anh-duynguyen/UCT_Micromouse_EEE3088F/Documentation/README.md

# Documentation

This folder contains datasheets and project documentation related to the EEE3088F course at UCT (in 2024).

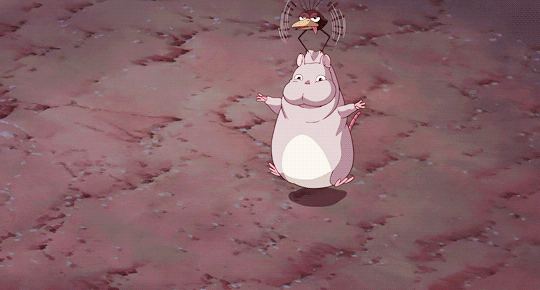
[picture p2: Documentation/Other/Formatting/tumblr_pffb1xFtaW1w67ki0o4_540.gif]
Mouse


## Sensing Module

This section contains datasheets and informational documents related to the sensors used and considered, as well as information about the STM32.

## Power Module

Find datasheets and informational documents related to power, usage and considerations, along with information about the STM32 in this section.

## Other

This section includes interfacing diagrams, the EEE3088F project brief, and a report regarding the Micromouse.

## Reports

Reports submitted for EEE3088F are available in both PDF and LaTeX formats. Please note that some of the links in these reports may not work due to the restructuring of this repository.
