anh-duynguyen/UCT_Micromouse_EEE3088F/Documentation/Reports/README.md

# Reports

This folder contains reports and latex files related to the EEE3088F course at UCT (in 2024).

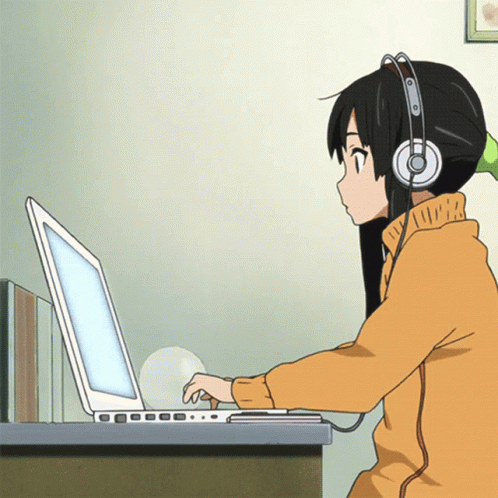
[picture p3: Documentation/Other/Formatting/tumblr_4429ca63f8072c9b22c431f62f48edd5_1a541d7b_500.gif]
Footprints
