anh-duynguyen/UCT_Micromouse_EEE3088F/Documentation/Power Module/README.md

# Power Module

Find datasheets and informational documents related to power, usage and considerations, along with information about the STM32 in this section.

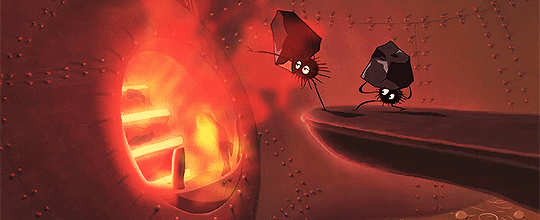
[picture p4: Documentation/Other/Formatting/tumblr_nyav9j0GF31tknp1oo2_540.gif]
Footprints
