anh-duynguyen/UCT_Micromouse_EEE3088F/Documentation/Sensing Module/README.md

# Sensing Module

This section contains datasheets and informational documents related to the sensors used and considered, as well as information about the STM32.

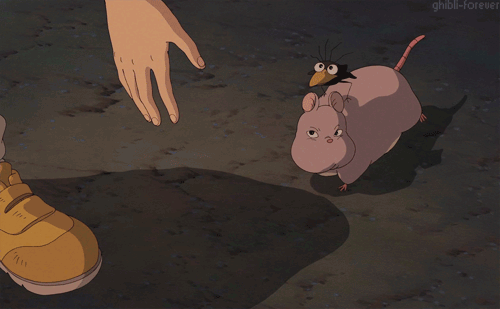
[picture p5: Documentation/Other/Formatting/tumblr_muf2ivJQ5h1rll7syo1_500.gif]
Footprints
