anh-duynguyen/UCT_Micromouse_EEE3088F/Documentation/Power Module/Datasheets/README.md

# Datasheets
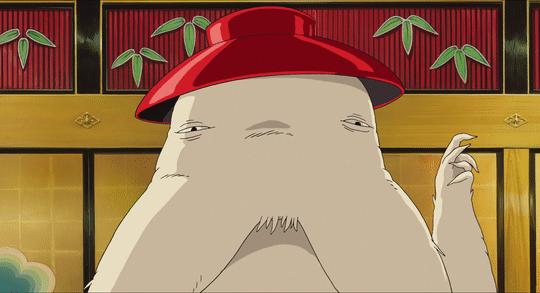
[picture p6: Documentation/Other/Formatting/0f9a2937e70205ddf1e4.gif]
Footprints
