anh-duynguyen/UCT_Micromouse_EEE3088F/Documentation/Sensing Module/Datasheets/README.md

# Datasheets
Footprints
