anh-duynguyen/UCT_Micromouse_EEE3088F/Documentation/Power Module/Footprints/README.md

# Footprints
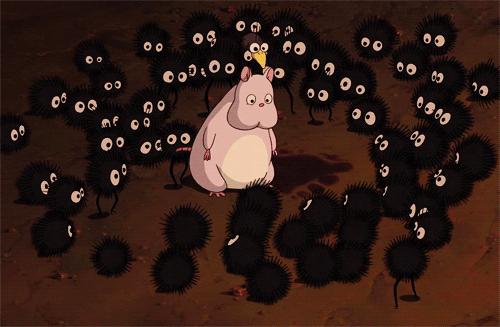
[picture p7: Documentation/Other/Formatting/45f478039f9f38e638831d6355e46289.gif]
Footprints
