anh-duynguyen/UCT_Micromouse_EEE3088F/Documentation/Sensing Module/KiCAD/Sensor_Schematic.pdf

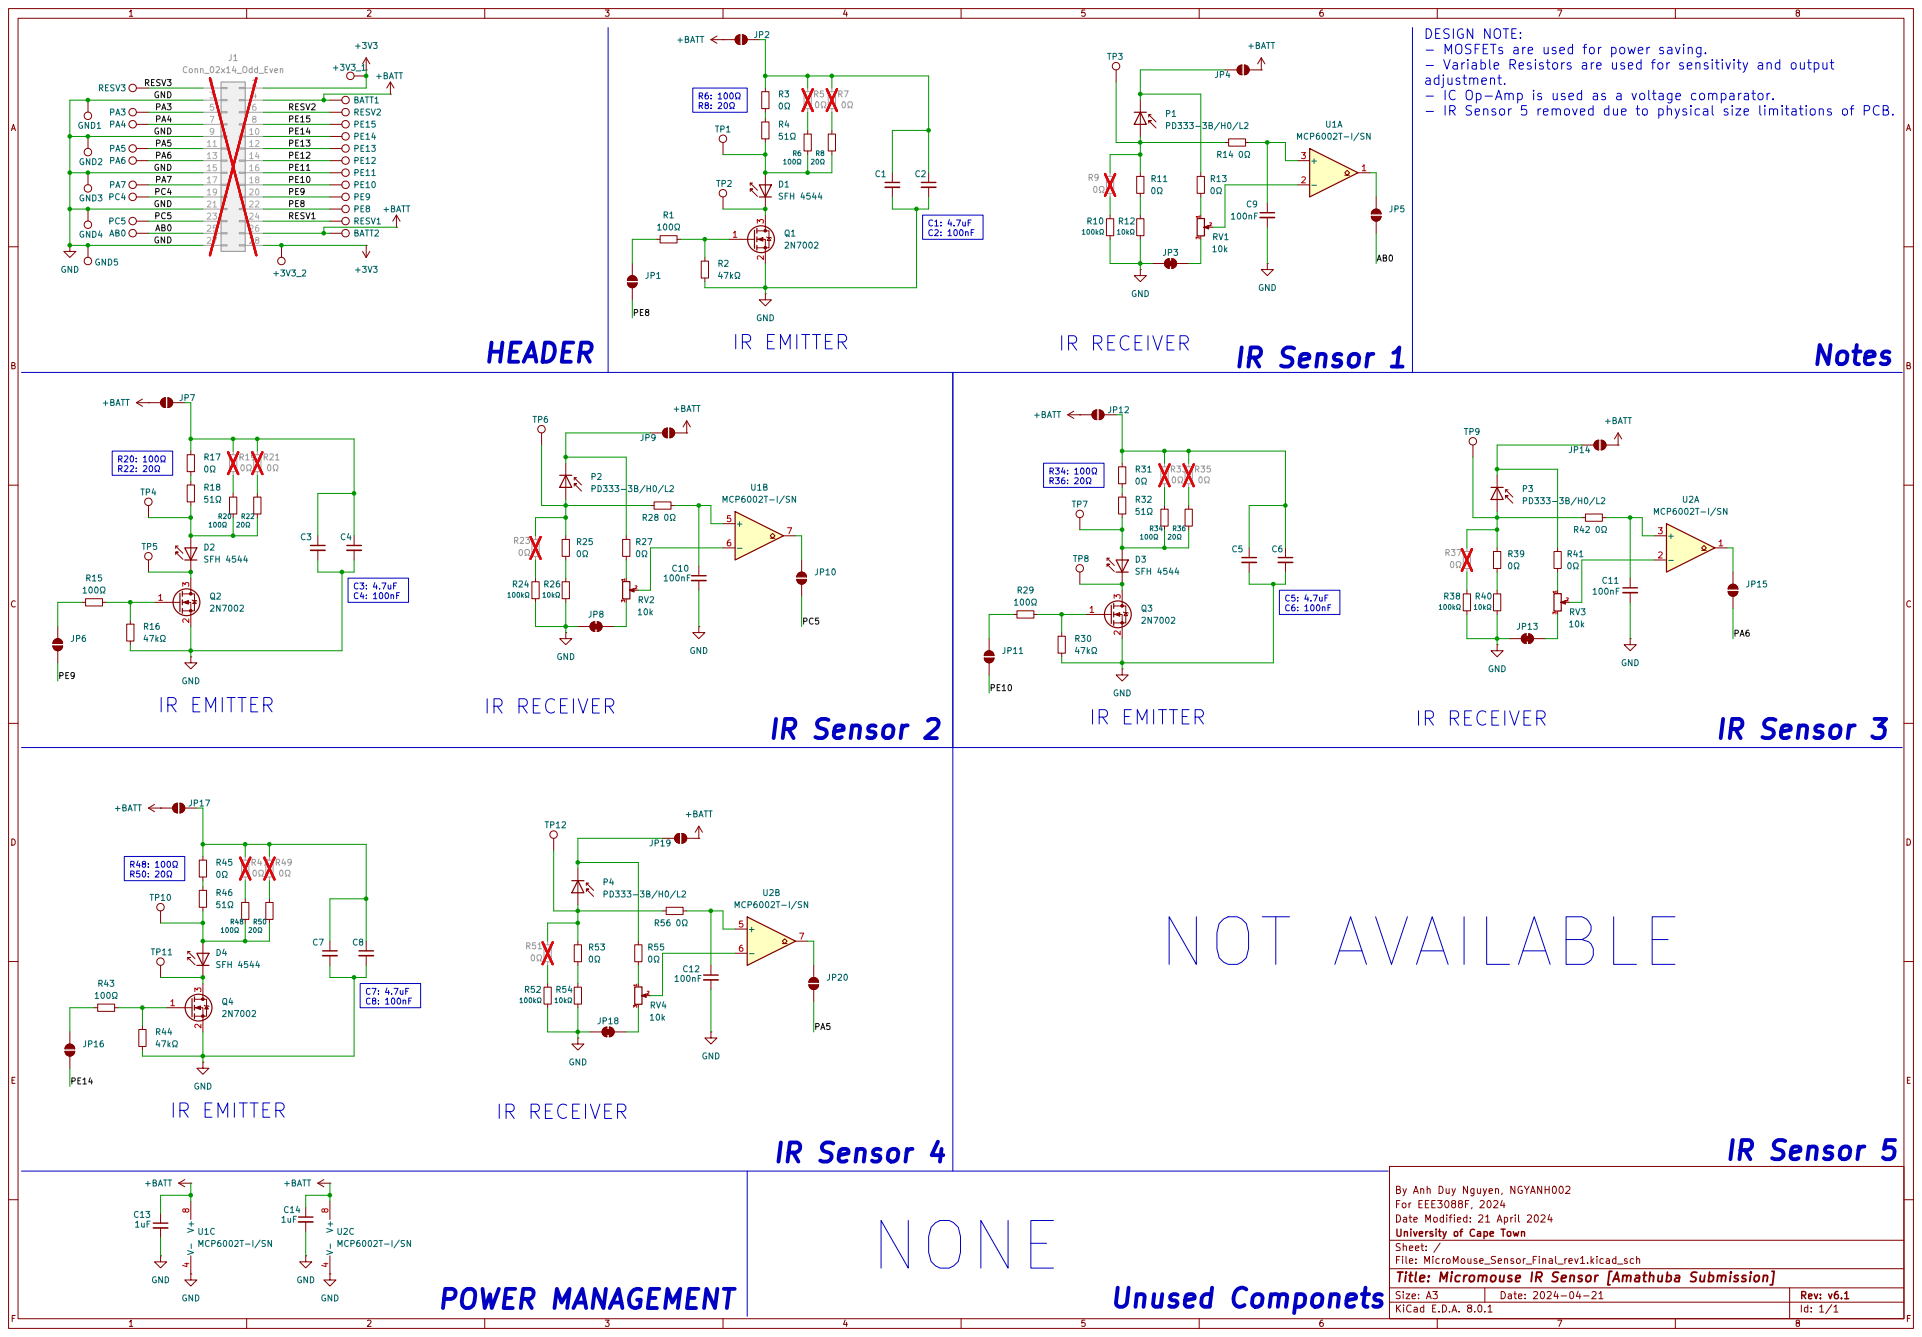
[picture p18: page 1]
