anh-duynguyen/UCT_Micromouse_EEE3088F/Documentation/Sensing Module/KiCAD/MicroMouse_Sensor_Amathuba/MicroMouse_Sensor_Amathuba.kicad_pcb

## KiCad design Documentation/Sensing Module/KiCAD/MicroMouse_Sensor_Amathuba/MicroMouse_Sensor_Amathuba.kicad_pcb (2024-04-21, last stored version)

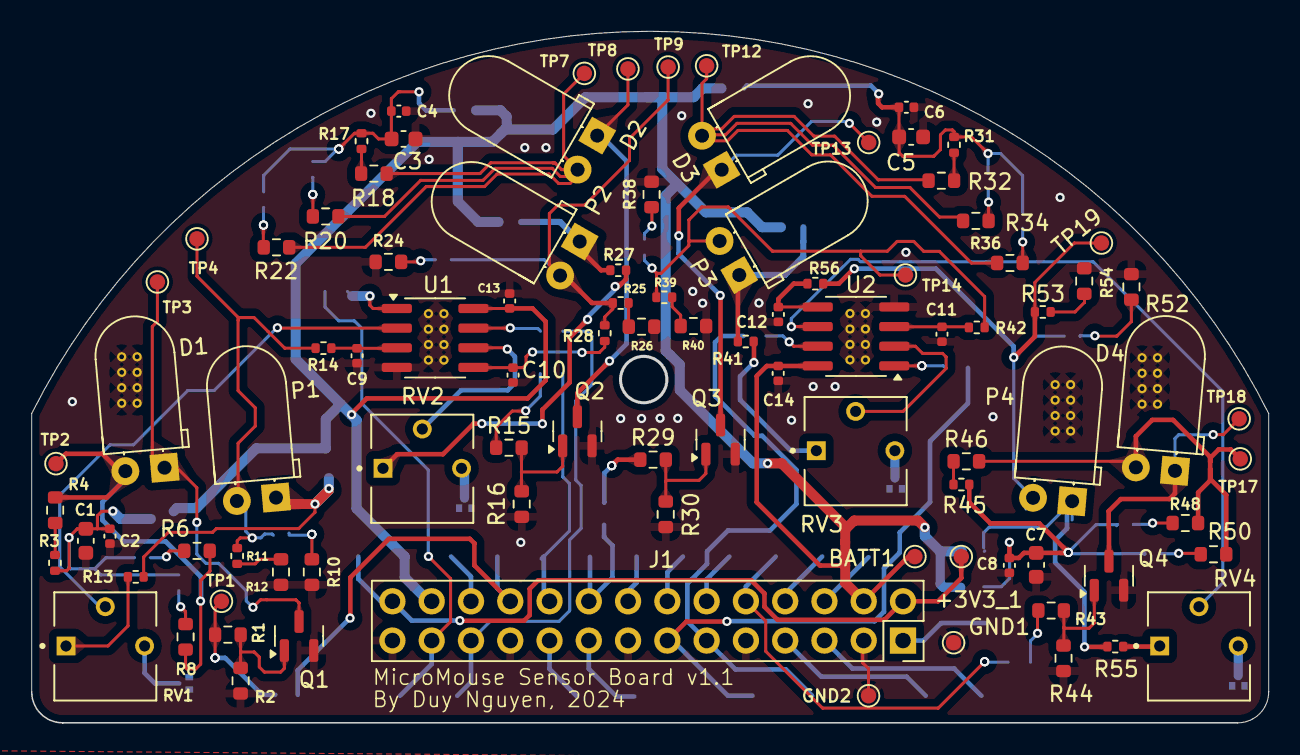
[picture p19: board MicroMouse_Sensor_Amathuba.kicad_pcb from above]

Board: 2 copper layers, 80.0 x 44.7 mm, 150 parts (0 on the bottom side), 90 nets.

Parts:
+3V3_1, +3V3_2: TestPoint; TestPoint_Pad_D1.0mm
AB0: TestPoint; TestPoint_Pad_D1.0mm
BATT1, BATT2: TestPoint; TestPoint_Pad_D1.0mm
C1, C3, C5, C7: 4.7µF; C_0603_1608Metric
C2, C4, C6, C8, C9, C10, C11, C12: 100nF; C_0402_1005Metric
C13, C14: 1uF; C_0402_1005Metric
D1, D2, D3, D4: SFH 4544; LED_D5.0mm_Horizontal_O1.27mm_Z3.0mm_IRGrey
GND1, GND2, GND3, GND4, GND5: TestPoint; TestPoint_Pad_D1.0mm
J1: Conn_02x14_Odd_Even; PinSocket_2x14_P2.54mm_Vertical
JP1, JP2, JP4, JP5, JP6, JP7, JP9, JP10, JP11, JP12, JP14, JP15, JP16, JP17, JP19, JP20: SolderJumper_2_Open; SolderJumper-2_P1.3mm_Open_TrianglePad1.0x1.5mm
JP3, JP8, JP13, JP18: SolderJumper_2_Bridged; SolderJumper-2_P1.3mm_Bridged2Bar_RoundedPad1.0x1.5mm
P1, P2, P3, P4: PD333-3B/H0/L2; LED_D5.0mm_Horizontal_O1.27mm_Z3.0mm
PA3, PA4, PA5, PA6, PA7: TestPoint; TestPoint_Pad_D1.0mm
PC4, PC5: TestPoint; TestPoint_Pad_D1.0mm
PE8, PE9, PE10, PE11, PE12, PE13, PE14, PE15: TestPoint; TestPoint_Pad_D1.0mm
Q1, Q2, Q3, Q4: 2N7002; SOT-23
R1, R6, R15, R20, R29, R34, R43, R48: 100Ω; R_0603_1608Metric
R2, R16, R30, R44: 47kΩ; R_0603_1608Metric
R3, R5, R7, R9, R11, R13, R14, R17, R19, R21, R23, R25, R27, R28, R31, R33, R35, R37, R39, R41, R42, R45, R47, R49, R51, R53, R55, R56: 0Ω; R_0402_1005Metric
R4, R18, R32, R46: 51Ω; R_0603_1608Metric
R8, R22, R36, R50: 20Ω; R_0603_1608Metric
R10, R24, R38, R52: 100kΩ; R_0603_1608Metric
R12, R26, R40, R54: 10kΩ; R_0603_1608Metric
RESV1, RESV2, RESV3: TestPoint; TestPoint_Pad_D1.0mm
RV1, RV2, RV3, RV4: 10k; TRIM_3362P-1-103
TP1, TP2, TP3, TP4, TP7, TP8, TP9, TP12, TP13, TP14, TP17, TP18, TP19: TestPoint; TestPoint_Pad_D1.0mm
U1, U2: MCP6002T-I/SN; SOIC-8_3.9x4.9mm_P1.27mm

Connections:
+3V3: +3V3_1.1, +3V3_2.1, J1.2, J1.28
+BATT: BATT1.1, BATT2.1, C13.1, C14.1, J1.4, J1.26, JP2.1 (A), JP4.1 (A), JP7.1 (A), JP9.1 (A), JP12.1 (A), JP14.1 (A), JP17.1 (A), JP19.1 (A), U1.8 (V+), U2.8 (V+)
/AB0: AB0.1, J1.25, JP5.1 (A)
/PA3: J1.5, PA3.1
/PA4: J1.7, PA4.1
/PA5: J1.11, JP20.1 (A), PA5.1
/PA6: J1.13, JP15.1 (A), PA6.1
/PA7: J1.17, PA7.1
/PC4: J1.19, PC4.1
/PC5: J1.23, JP10.1 (A), PC5.1
/PE8: J1.22, JP1.1 (A), PE8.1
/PE9: J1.20, JP6.1 (A), PE9.1
/PE10: J1.18, JP11.1 (A), PE10.1
/PE11: J1.16, PE11.1
/PE12: J1.14, PE12.1
/PE13: J1.12, PE13.1
/PE14: J1.10, JP16.1 (A), PE14.1
/PE15: J1.8, PE15.1
/RESV1: J1.24, RESV1.1
/RESV2: J1.6, RESV2.1
/RESV3: J1.1, RESV3.1
GND: C1.2, C2.2, C3.2, C4.2, C5.2, C6.2, C7.2, C8.2, C9.2, C10.2, C11.2, C12.2, C13.2, C14.2, GND1.1, GND2.1, GND3.1, GND4.1, GND5.1, J1.3, J1.9, J1.15, J1.21, J1.27, JP3.1 (A), JP8.1 (A), JP13.1 (A), JP18.1 (A), Q1.2 (S), Q2.2 (S), Q3.2 (S), Q4.2 (S), R2.2, R10.2, R12.2, R16.2, R24.2, R26.2, R30.2, R38.2, R40.2, R44.2, R52.2, R54.2, U1.4 (V-), U2.4 (V-)
unnamed: D1.2 (A), R4.2, R6.2, R8.2, TP2.1
unnamed: D1.1 (K), Q1.3 (D), TP3.1
unnamed: D2.2 (A), R18.2, R20.2, R22.2, TP7.1
unnamed: D2.1 (K), Q2.3 (D), TP8.1
unnamed: D3.2 (A), R32.2, R34.2, R36.2, TP12.1
unnamed: D3.1 (K), Q3.3 (D), TP13.1
unnamed: D4.2 (A), R46.2, R48.2, R50.2, TP17.1
unnamed: D4.1 (K), Q4.3 (D), TP18.1
unnamed: JP1.2 (B), R1.1, TP1.1
unnamed: C1.1, C2.1, JP2.2 (B), R3.1, R5.1, R7.1
unnamed: JP3.2 (B), RV1.3
unnamed: JP4.2 (B), P1.1 (K), R13.1
unnamed: JP5.2 (B), U1.1
unnamed: JP6.2 (B), R15.1
unnamed: C3.1, C4.1, JP7.2 (B), R17.1, R19.1, R21.1
unnamed: JP8.2 (B), RV2.3
unnamed: JP9.2 (B), P2.1 (K), R27.1
unnamed: JP10.2 (B), U1.7
unnamed: JP11.2 (B), R29.1
unnamed: C5.1, C6.1, JP12.2 (B), R31.1, R33.1, R35.1
unnamed: JP13.2 (B), RV3.3
unnamed: JP14.2 (B), P3.1 (K), R41.1
unnamed: JP15.2 (B), U2.1
unnamed: JP16.2 (B), R43.1
unnamed: C7.1, C8.1, JP17.2 (B), R45.1, R47.1, R49.1
unnamed: JP18.2 (B), RV4.3
unnamed: JP19.2 (B), P4.1 (K), R55.1
unnamed: JP20.2 (B), U2.7
unnamed: P1.2 (A), R9.1, R11.1, R14.1, TP4.1
unnamed: P2.2 (A), R23.1, R25.1, R28.1, TP9.1
unnamed: P3.2 (A), R37.1, R39.1, R42.1, TP14.1
unnamed: P4.2 (A), R51.1, R53.1, R56.1, TP19.1
unnamed: Q1.1 (G), R1.2, R2.1
unnamed: Q2.1 (G), R15.2, R16.1
unnamed: Q3.1 (G), R29.2, R30.1
unnamed: Q4.1 (G), R43.2, R44.1
unnamed: R3.2, R4.1
unnamed: R5.2, R6.1
unnamed: R7.2, R8.1
unnamed: R9.2, R10.1
unnamed: R11.2, R12.1
unnamed: R13.2, RV1.1
unnamed: R17.2, R18.1
unnamed: R19.2, R20.1
unnamed: R21.2, R22.1
unnamed: R23.2, R24.1
unnamed: R25.2, R26.1
unnamed: R27.2, RV2.1
unnamed: R31.2, R32.1
unnamed: R33.2, R34.1
unnamed: R35.2, R36.1
unnamed: R37.2, R38.1
unnamed: R39.2, R40.1
unnamed: R41.2, RV3.1
unnamed: R45.2, R46.1
unnamed: R47.2, R48.1
unnamed: R49.2, R50.1
unnamed: R51.2, R52.1
unnamed: R53.2, R54.1
unnamed: R55.2, RV4.1
unnamed: C9.1, R14.2, U1.3 (+)
unnamed: RV1.2, U1.2 (-)
unnamed: C10.1, R28.2, U1.5 (+)
unnamed: RV2.2, U1.6 (-)
unnamed: C11.1, R42.2, U2.3 (+)
unnamed: RV3.2, U2.2 (-)
unnamed: C12.1, R56.2, U2.5 (+)
unnamed: RV4.2, U2.6 (-)
