anh-duynguyen/UCT_Micromouse_EEE3088F/(commit log)

2024-03-18 Create README.md for Power
2024-03-18 STM32 Datasheet
2024-03-18 Create README.md for Power Datasheets
2024-03-18 STM32 Datasheet for Power
2024-03-18 Create README.md for Footprints
2024-03-18 Adding footprints
2024-04-07 Power Subsystem Active Component Datasheets
2024-04-07 Power Subsystem Active Component Footprints
2024-04-21 Create KiCAD
2024-04-21 Incomplete Report Submitted...
    The constraint of limited knowledge required to write a report, well-formatted, with tables and figures, was a limitation I did not foresee in advance. This led to unforeseen delays in compiling the required information for submission. However, albeit a little too late this time to improve, the aim of improving is what will inform the duration of time delegated to future reports written in LaTeX.
2024-04-21 Schematic Quality Improvement Technique
    By;
    i) Printing the KiCad schematic (CTRL+P)
    ii) Then selecting to save a .PDF copy
    iii) One can open the .pdf in Adobe Illustrator
    iv) crop the image by selecting the rectangle tool on the side bar
    v) and cover the desired image with the blank rectangle
    vi) thereafter (with the rectangle still "highlighted"), on the top of the page navigate to Select->Object->(All on Same Layers)
    vii) penultimately, left-click on the blank rectangle and click on-> "Make Clipping Mask"
    viii) Navigate to File->Export->(Export as...)
    ix) Save the file as a JPEG, or whatever is applicable for the application
    x) Then Select the following: (Colour Model : RGB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
2024-05-06 Schematic Quality Improvement Technique Correction
2024-07-29 current progress on status report
